dbsousa01/scdtr/Code arduino/serial_comm.cpp

#include "serial_comm.h"


void serial_write(char * msg){
    int fd = open(PORT, O_RDWR);
    if (fd == -1) {
      perror("/dev/ttyACM0");
    }

    char msg_aux[100];
    memset(msg_aux,'\0',100);
    sprintf(msg_aux,"%s",msg);
    struct termios tios;
    tcgetattr(fd, &tios);
    // disable flow control and all that, and ignore break and parity errors
    tios.c_iflag = IGNBRK | IGNPAR;
    tios.c_oflag = 0;
    tios.c_lflag = 0;
    cfsetspeed(&tios, B115200);
    tcsetattr(fd, TCSAFLUSH, &tios);

    // the serial port has a brief glitch once we turn it on which generates a
    // start bit; sleep for 1ms to let it settle
    usleep(1000);    


    // output to serial port
    //char msg[] = "hi there";
    write(fd, msg_aux, strlen(msg_aux));
    printf("Enviei para o arduino: %s\n",msg_aux );
    /*char c;
    for(;;){
        if(read(fd,&c,1)>0){
            fprintf(stdout,"%c\n", c);  
        }       
    }*/
    close(fd);
}
